LeungLoh/microgrid/README.md

微电网模拟系统：
程序：
电路1是主电路程序，电路2副电路程序，2者几乎相同，区别点在于电路2回去捕获电路1的输出波形进行锁相
msp430f5529是最开始采用的是430单片机，无法解决问题，后来采用stm32

电路：
主电路，采样电路，以及单片机的最小系统

文档内容是对系统的详细描述
