LeungLoh/microgrid/(list of files, drawings)

Other design files:
STM32F103最小系统/PCB1.PcbDoc
STM32F103最小系统/PCB_Project.PrjPcb
STM32F103最小系统/PcbLib1.PcbLib
STM32F103最小系统/Schlib1.SchLib
STM32F103最小系统/Sheet1.SchDoc
主功率板/功率主板/功率主板.PcbDoc
主功率板/功率主板/功率主板.PrjPcb
主功率板/功率主板/功率主板.SchDoc
输出采样部分带过零比较部分/四路输出采样部分/PCB1.PcbDoc
输出采样部分带过零比较部分/四路输出采样部分/输出采样部分.PrjPcb
输出采样部分带过零比较部分/四路输出采样部分/输出采样部分.SchDoc
